Harindra1410/Dental-spectrophotometer/(list of files, cad)

Other CAD files:
Mechanical Design/Assembly_final.f3z
