Harindra1410/Dental-spectrophotometer/Circuit Cadding/Schematic.pdf

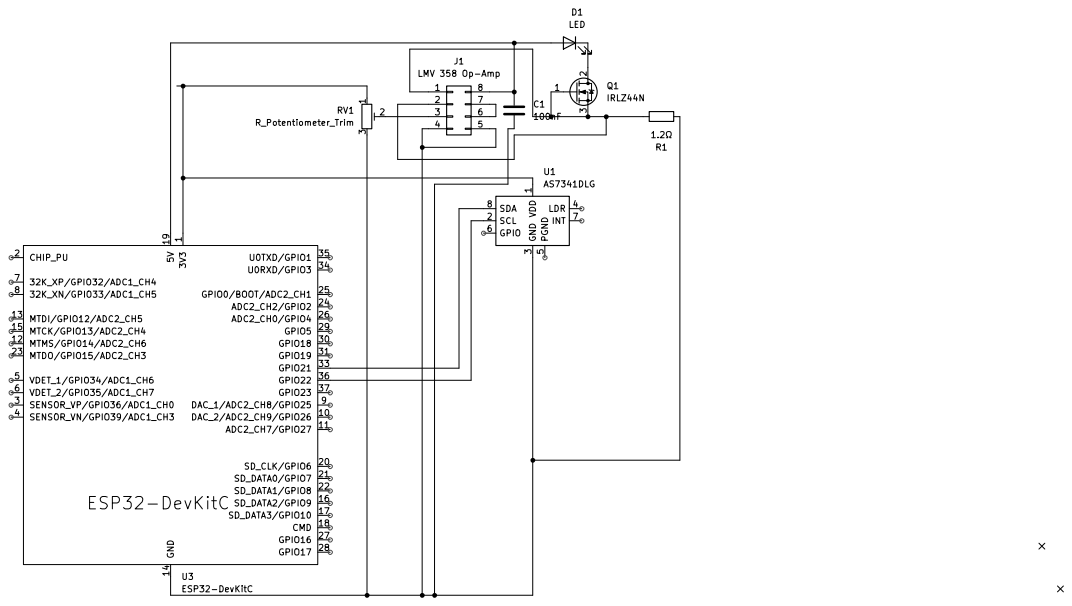
[picture p3: page 1]
