Harindra1410/Dental-spectrophotometer/Simulation/LED Current Driver Simulation.asc

D1: LED
M1: nmos; IRLZ44N
R1: res; 1.2
U2: LT1490
V1: voltage; 5
V2: voltage; 0.15
Named nets: 0
.tran 10m
.MODEL IRLZ44N NMOS(Level=3 Gamma=0 Vto=2.1 Tox=20n Phi=.6 Rs=5m Rd=1m Vmax=0 
+ Kappa=0 Eta=0 Theta=0 Pb=1 Ibv=10u Xj=0 Mj=.5 Pbv=1 Mjg=.5 Js=0 
+ Jss=0 Tref=27 Rdf=0 Ff=1 Sp=1 Cgso=1.96n Cgdo=0.33n Cgbo=0 T_measured=27 
+ A=1.58 B=1.45 C=1.35 D=1.05 E=0.75 F=0.65 Breakdown=1 N_channel=1 
+ Vdss=55 Rds_on=17.5m Id_max=47 Qg_total=48n)
.SUBCKT irlz44n 1 2 3
**************************************
*      Model Generated by MODPEX     *
*Copyright(c) Symmetry Design Systems*
*         All Rights Reserved        *
*    UNPUBLISHED LICENSED SOFTWARE   *
*   Contains Proprietary Information *
*      Which is The Property of      *
*     SYMMETRY OR ITS LICENSORS      *
*Commercial Use or Resale Restricted *
*   by Symmetry License Agreement    *
**************************************
* Model generated on Apr 24, 96
* Model format: SPICE3
* Symmetry POWER MOS Model (Version 1.0)
* External Node Designations
* Node 1 -> Drain
* Node 2 -> Gate
* Node 3 -> Source
M1 9 7 8 8 MM L=100u W=100u
* Default values used in MM:
* The voltage-dependent capacitances are
* not included. Other default values are:
*   RS=0 RD=0 LD=0 CBD=0 CBS=0 CGBO=0
.MODEL MM NMOS LEVEL=1 IS=1e-32
+VTO=2.08819 LAMBDA=0.0038193 KP=67.9211
+CGSO=1.59143e-05 CGDO=3.04562e-08
RS 8 3 0.014066
D1 3 1 MD
.MODEL MD D IS=4.4574e-09 RS=0.007275 N=1.40246 BV=55
+IBV=0.00025 EG=1.14011 XTI=3.00078 TT=0
+CJO=8.92434e-10 VJ=4.94724 M=0.75496 FC=0.5
RDS 3 1 2.2e+06
RD 9 1 0.00179971
RG 2 7 2.4114
D2 4 5 MD1
* Default values used in MD1:
*   RS=0 EG=1.11 XTI=3.0 TT=0
*   BV=infinite IBV=1mA
.MODEL MD1 D IS=1e-32 N=50
+CJO=1.15401e-09 VJ=0.859156 M=0.642548 FC=1e-08
D3 0 5 MD2
* Default values used in MD2:
*   EG=1.11 XTI=3.0 TT=0 CJO=0
*   BV=infinite IBV=1mA
.MODEL MD2 D IS=1e-10 N=0.4 RS=3e-06
RL 5 10 1
FI2 7 9 VFI2 -1
VFI2 4 0 0
EV16 10 0 9 7 1
CAP 11 10 3.64838e-09
FI1 7 9 VFI1 -1
VFI1 11 6 0
RCAP 6 10 1
D4 0 6 MD3
* Default values used in MD3:
*   EG=1.11 XTI=3.0 TT=0 CJO=0
*   RS=0 BV=infinite IBV=1mA
.MODEL MD3 D IS=1e-10 N=0.4
.ENDS
